georgiananaftanaila/Series-Voltage-Regulator/Layout/Layout.jpg

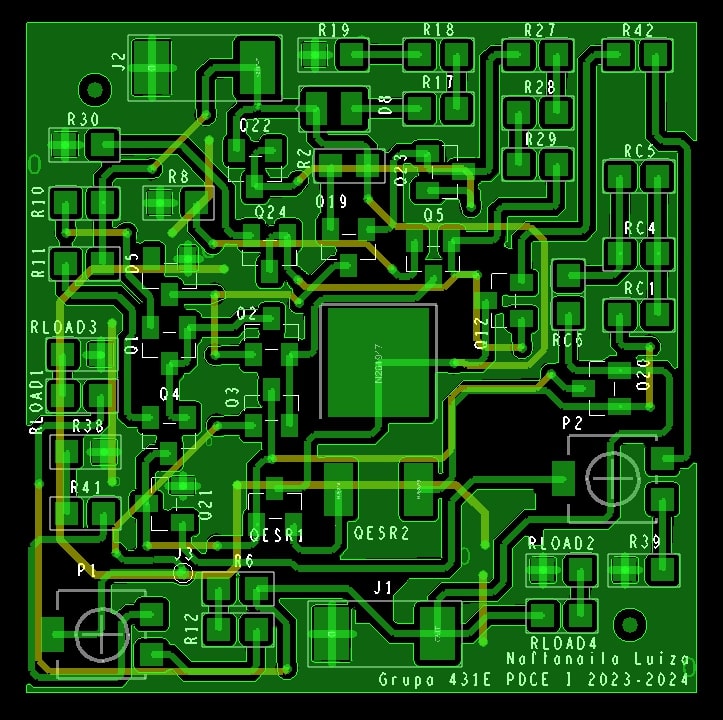
Layout/Layout.jpg
