georgiananaftanaila/Series-Voltage-Regulator/Proiect docs/Proiect1_Naftanaila_Luiza-Georgiana.pdf

Universitatea Națională de Știință si Tehnologie POLITEHNICA București

### FACULTATEA DE ELECTRONICĂ, TELECOMUNICAȚII ȘI TEHNOLOGIA INFORMAȚIEI

## STABILIZATOR DE TENSIUNE CU ELEMENT DE REGLAJ SERIE

## Proiect 1-DCE

Student: Năftănăilă Luiza-Georgiana

Grupa: 431E

Disciplină: PDCE

## Tema 7

(N = 17)

### 1. Date de proiectare

- Să se proiecteze și realizeze un stabilizator de tensiune cu ERS având următoarele caracteristici:

¨ Tensiunea de ieșire reglabilă în intervalul: 8.5-17 [V]

¨ Element de reglaj serie;

¨ Sarcina la ieșire 850 [Ω];

¨ Deriva termică < 2mV/°C;

¨ Protecție la suprasarcină prin limitarea temperaturii tranzistorului element de reglaj serie la 100 °C, si a curentului maxim la 0,4A;

¨ Tensiune de intrare în intervalul: 30.6-34 [V]

¨ Domeniul temperaturilor de funcționare: 0°C -70°C (verificabil prin testare în temperatură);

¨ Amplificarea în tensiune minimă (în buclă deschisă) a amplificatorului de eroare: minim 200;

¨ Semnalizarea prezenței tensiunilor de intrare/ieșire cu diodă de tip LED

## 2. Schema bloc- Stabilizator de tensiune ERS

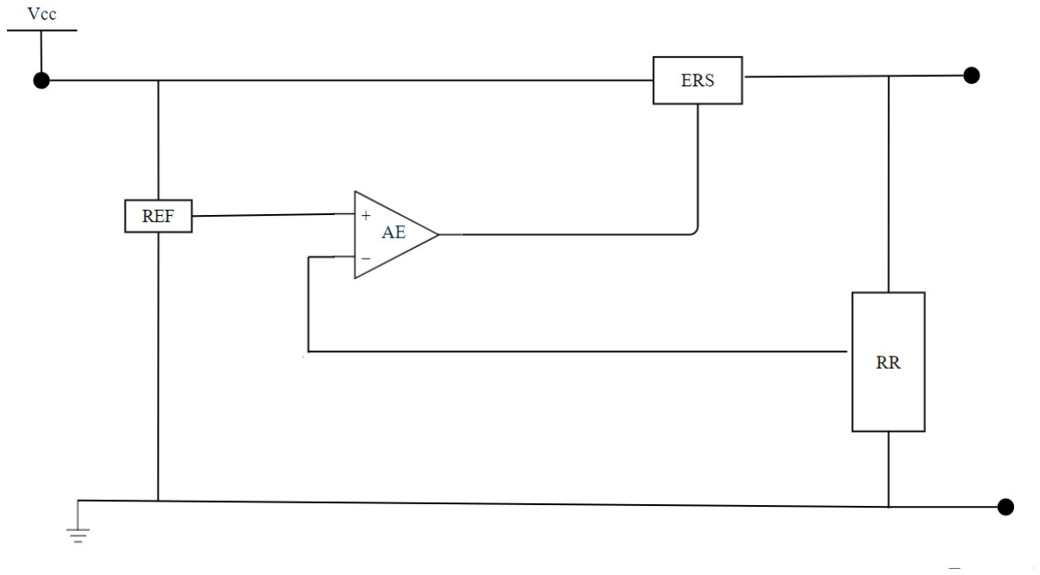
[picture p2: figure]

- REF – Referința de tensiune - asigură stabilitate în timp la variația tensiunii de intrare și a temperaturii;

- ERS - Elementul de reglaj serie - menține tensiunea de ieșire la nivelul specificat sub controlul amplificatorului de eroare;
- RR – Rețeaua de reacție negativă – preia semnalul de ieșire de la ieșirea amplificatorului în sensul scăderii amplitudinii acestuia;
- AE – Amplificatorul de eroare compară tensiunea de ieșire, pentru a acționa asupra elementului de reglaj;

## 3. Schema electrică

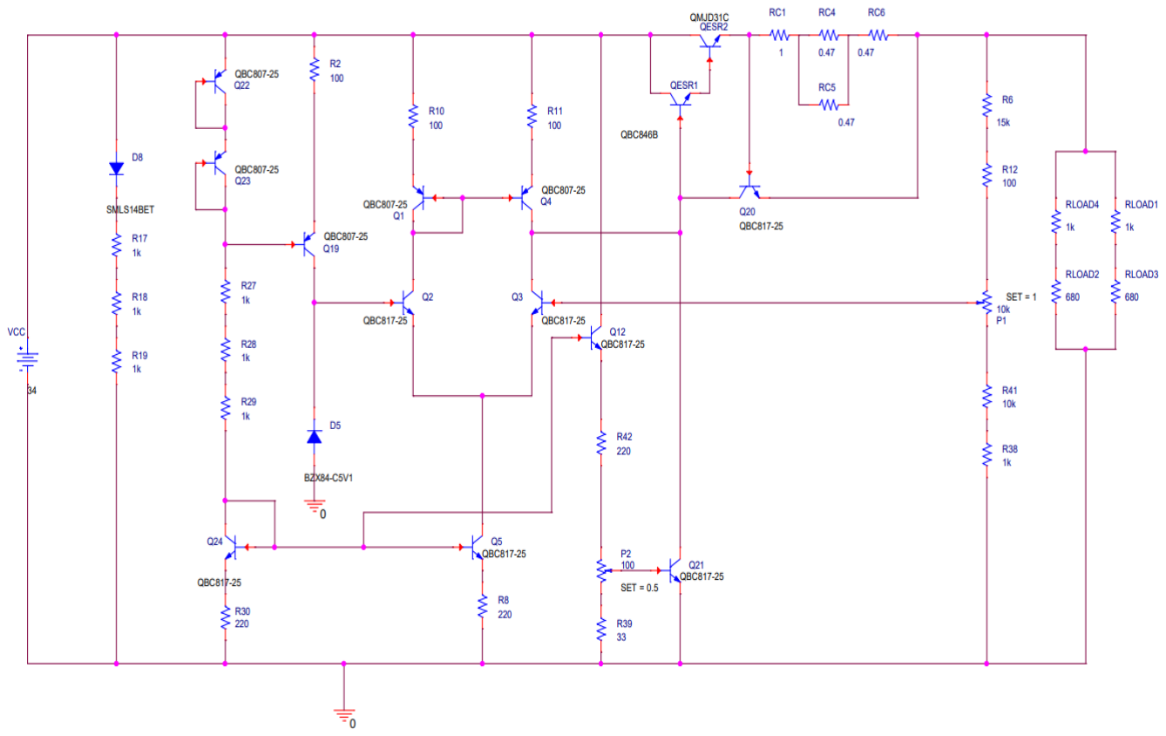
[picture p3: figure]

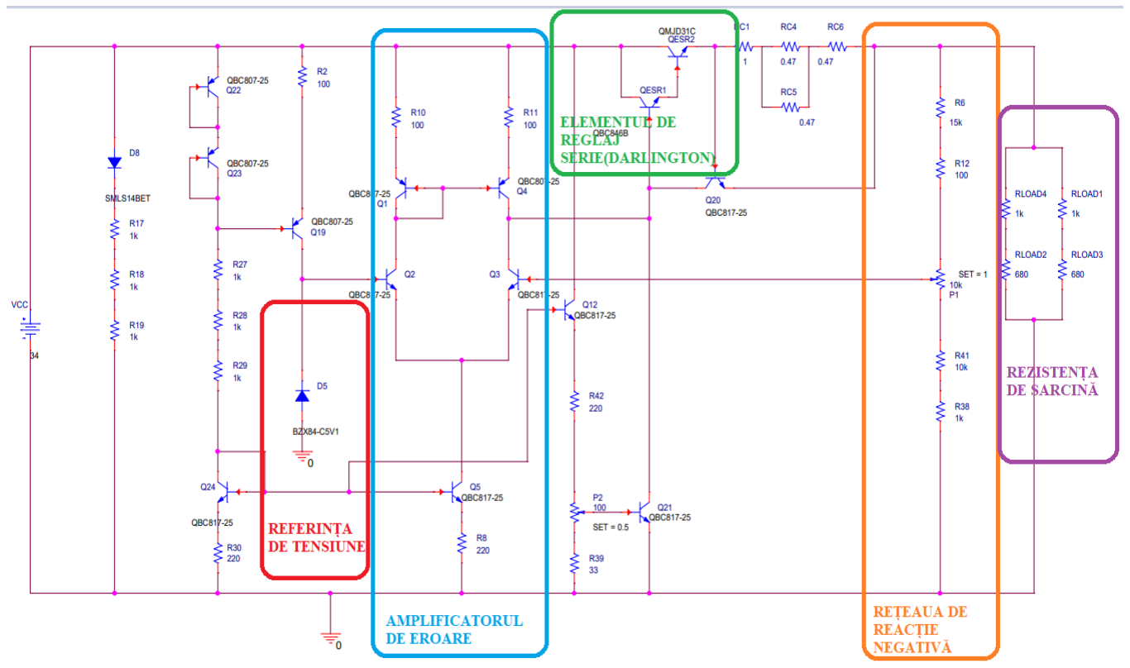
[picture p4: figure]

Rolul principalelor elemente din circuit:

- Dioda Zener, D5 este referința de tensiune și este polarizată de sursa de curent Q22,Q23,R2;
- Etajul diferențial Q2 și Q3, împreună cu sursa de curent Q5 și R8 și oglinda de curent Q1, Q4, R10 și R11 formează amplificatorul de eroare;
- Grupul QERS-QERS2 constituie elementul de reglaj serie, deoarece QESR2 este un tranzistor de putere (bF redus) care dă curentul prin sarcină. Tranzistorul QERS are rolul de demultiplicare a curentului de bază al lui QESR2 și face posibilă funcționarea amplificatorului de eroare la curenți acceptabili;
- Gruparea serie a rezistoarelor R6, R12, R37, R41, R38, R9, R34, împreună cu potențiometrul P1 formează rețeaua de reacție negativă, iar valorile acestora au fost alese astfel încât să regleze tensiunea de ieșire în intervalul dorit;
- Gruparea rezistoarelor RLOAD, RLOAD1-RLOAD7 formează rezistența de sarcină și au fost alese astfel încât puterea disipată pe fiecare dintre acestea să nu depășească 125 mW, impusă de producător;
- Oglinda de curent are rolul de a asigura curenți egali prin cele două ramuri;
- Q21 îndeplinește rolul senzorului de temperatură, iar tensiunea VBE a acestuia, la care poate să conducă un curent semnificativ, scade cu 2 mV/°C;
- Potențiometrul P2 are rolul de a ajusta valoarea divizorului de tensiune, R32, R42, R43, R39, P2, astfel încât tensiunea din emitorul lui Q12 să deschidă pe Q21 la circa 100°C;
- Valoarea diodei Zener a fost aleasă astfel încât coeficientul de variație cu temperatura să fie mic, aproape de 0, această dioda de 5.1V avand un drift termic foarte mic;
- Calculul PSF-ului de mai jos s-a realizat pentru o rezistență de sarcină de 850 Ω, dar aceasta a fost înlocuită cu un grup de mai multe rezistoare deoarece puterea disipată printr-o singură rezistență de această valoare este prea mare;
- Pentru a asigura un curent adecvat aprinderii LED-ului D8 s-au ales rezistoare de valoarea 1kΩ, respectiv 220Ω și 150Ω pentru aprinderea LED-ului D9;

- Rezistoarele ce fac parte din oglinda de curent au rolul de a egala cei doi curenți, având o cădere de tensiune mică pe aceștia;
- Rezistoarele înseriate cu LED-urile au rolul de a prelua o mare parte a tensiunii de intrare/ieșire;
- Tranzistorul Q20 împreună cu gruparea de rezistoare formată din RC1,RC4, RC5, RC6 asigură protecția la scurtcircuit. Valorile rezistoarelor au fost alese astfel încât prin tranzistorul QESR2 să fie forțat un curent mare și pentru a se asigura un curent optim pentru a ține tensiunea de ieșire constantă;
- Pentru potențiometrul ajustat la SET=1, valoarea tensiunii de ieșire se va calcula astfel:

Vz = Vo

R41+R38+P1
R6+R12+P1+R41+R38
- Vo = Vz

R6+R12+P1+R41+R38
R41+R38+P1

## 4. Calcul analitic și relații de dimensionare

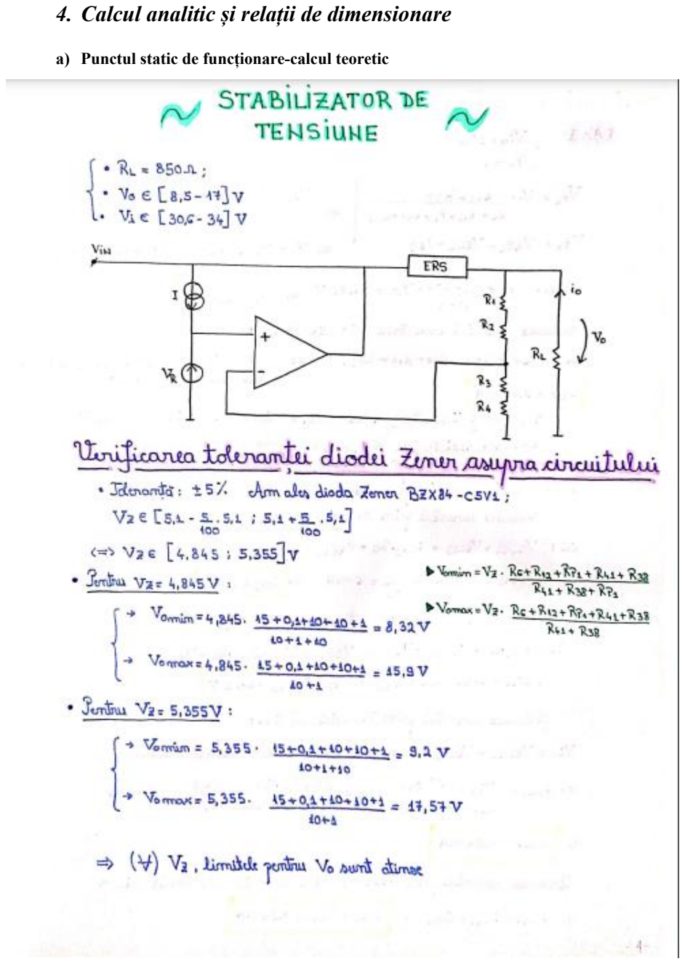
[picture p5: page 6]

a) Punctul static de funcționare-calcul teoretic

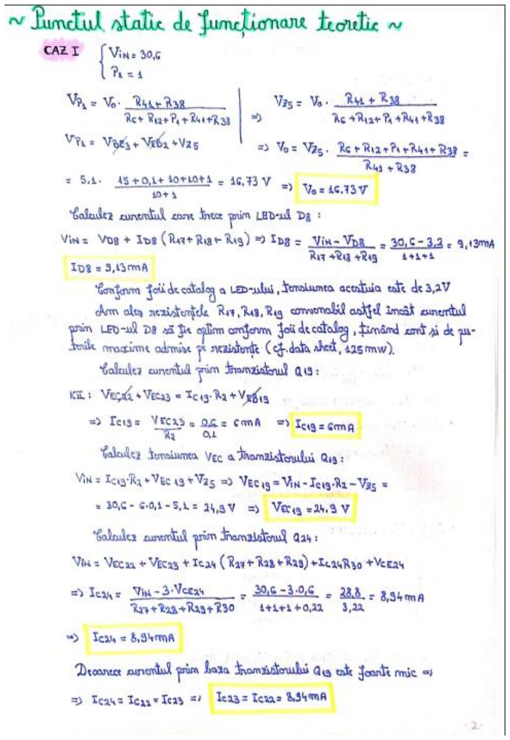
[picture p6: page 7]
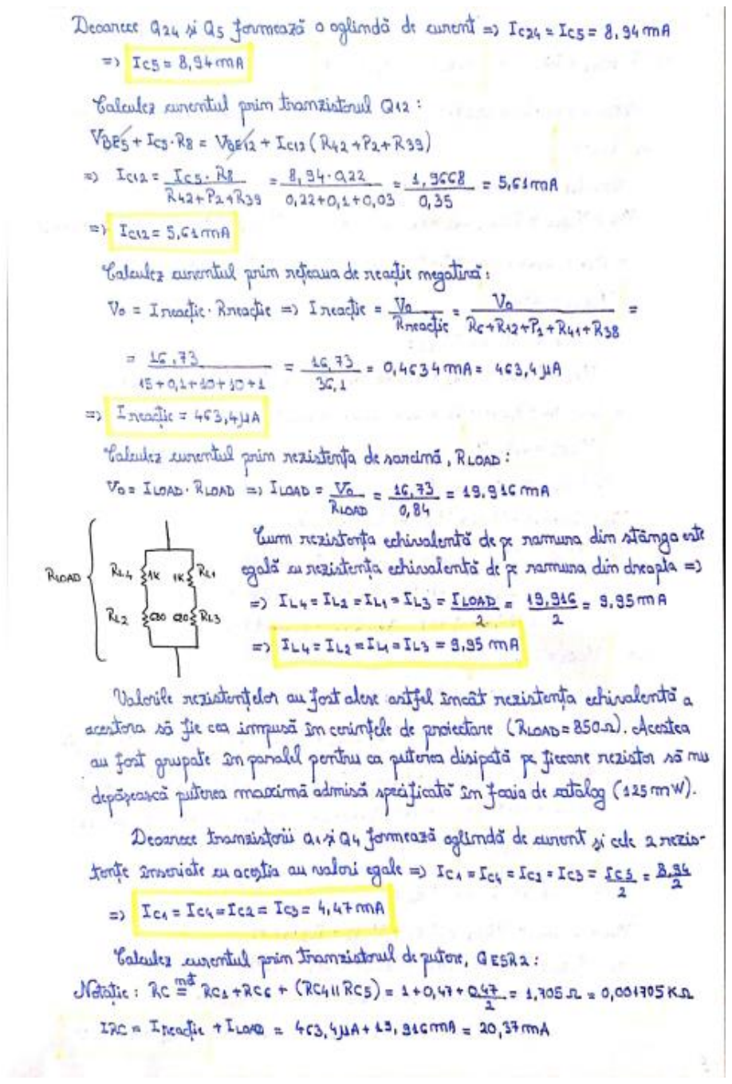
[picture p7: page 8]
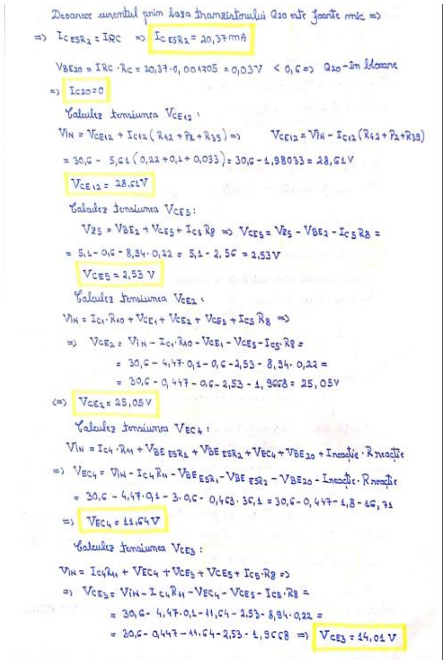
[picture p8: page 9]
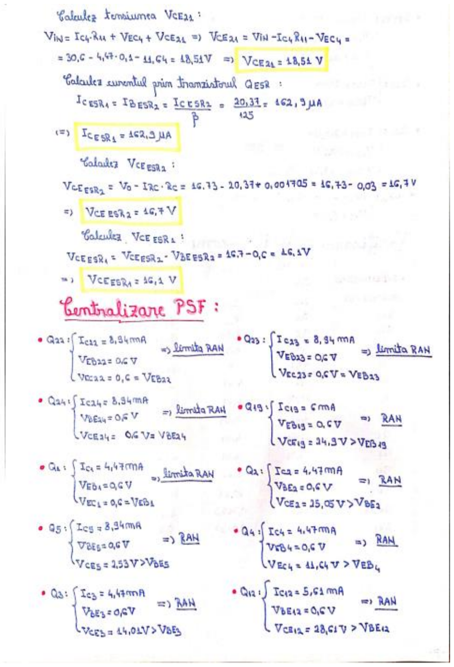
[picture p9: page 10]
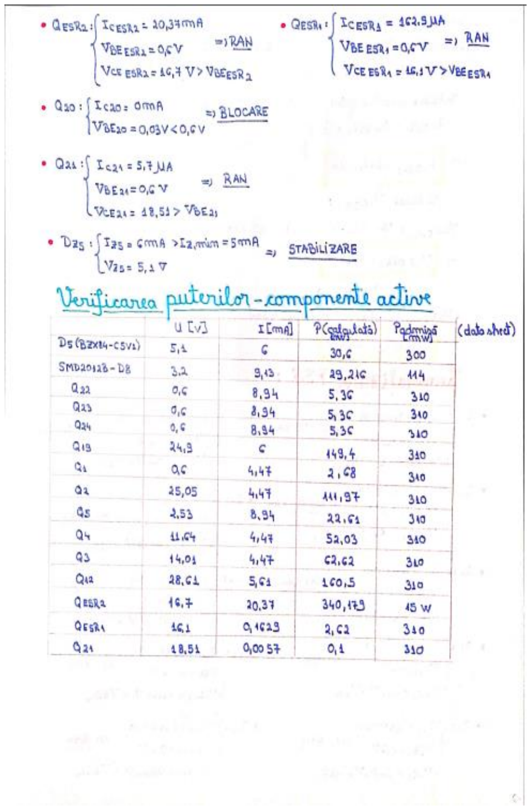
[picture p10: page 11]
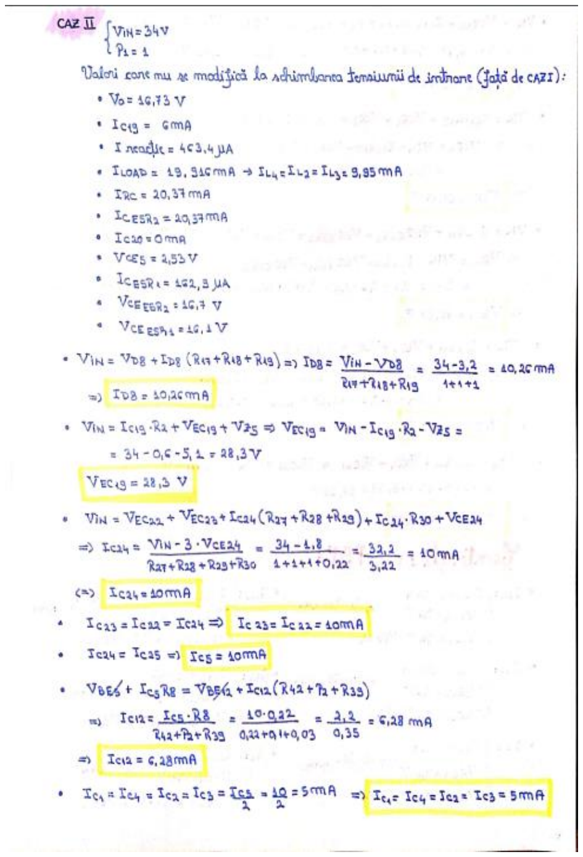
[picture p11: page 12]
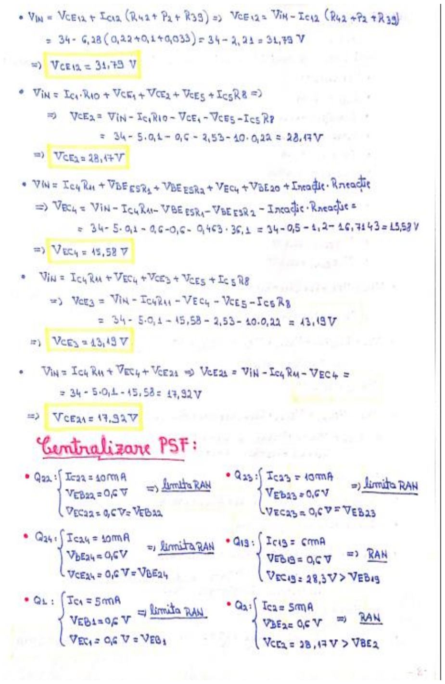
[picture p12: page 13]
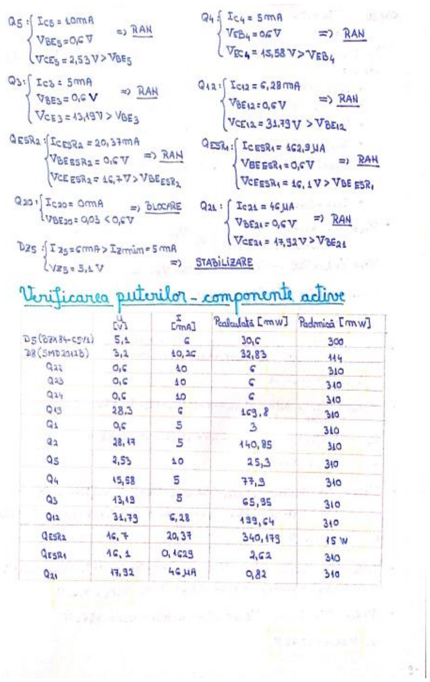
[picture p13: page 14]
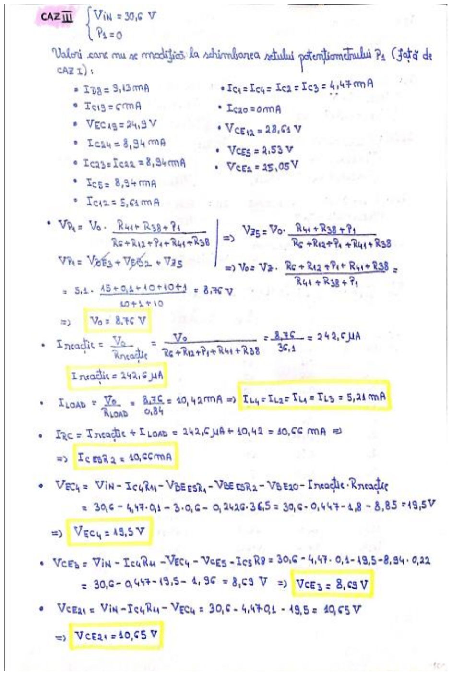
[picture p14: page 15]
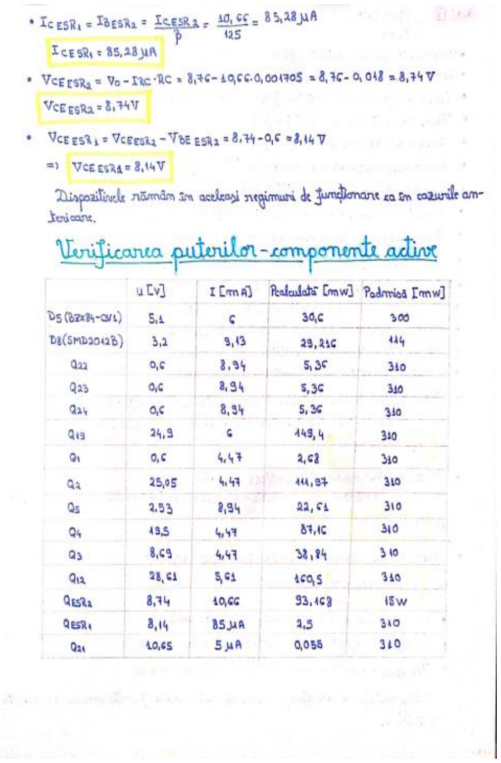
[picture p15: page 16]
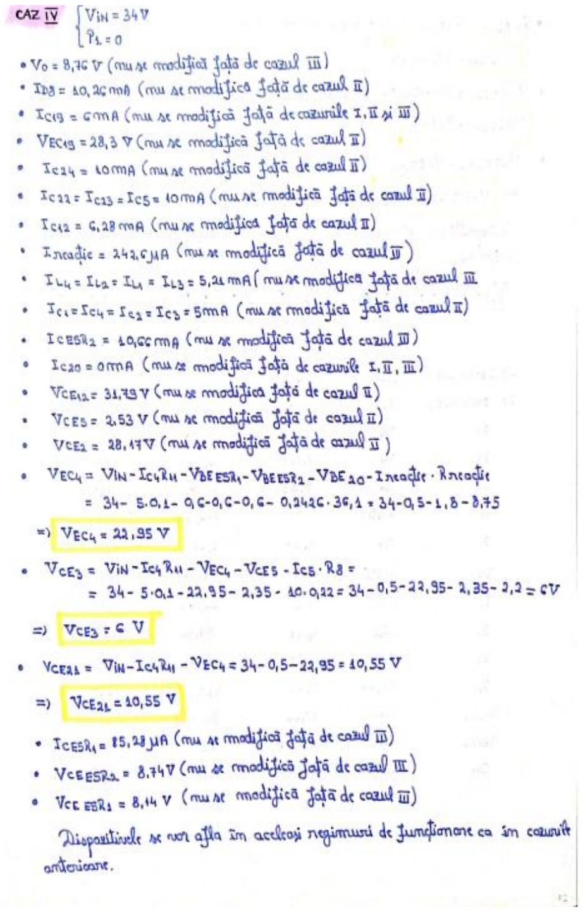
[picture p16: page 17]
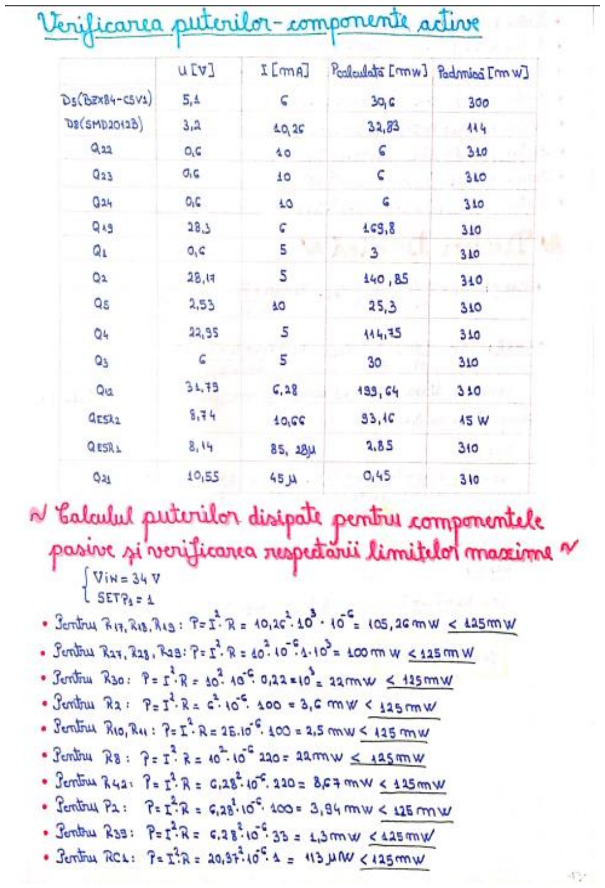
[picture p17: page 18]
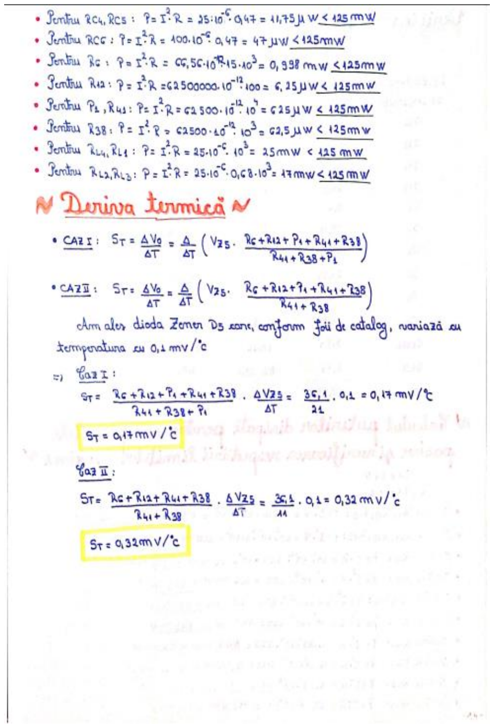
[picture p18: page 19]
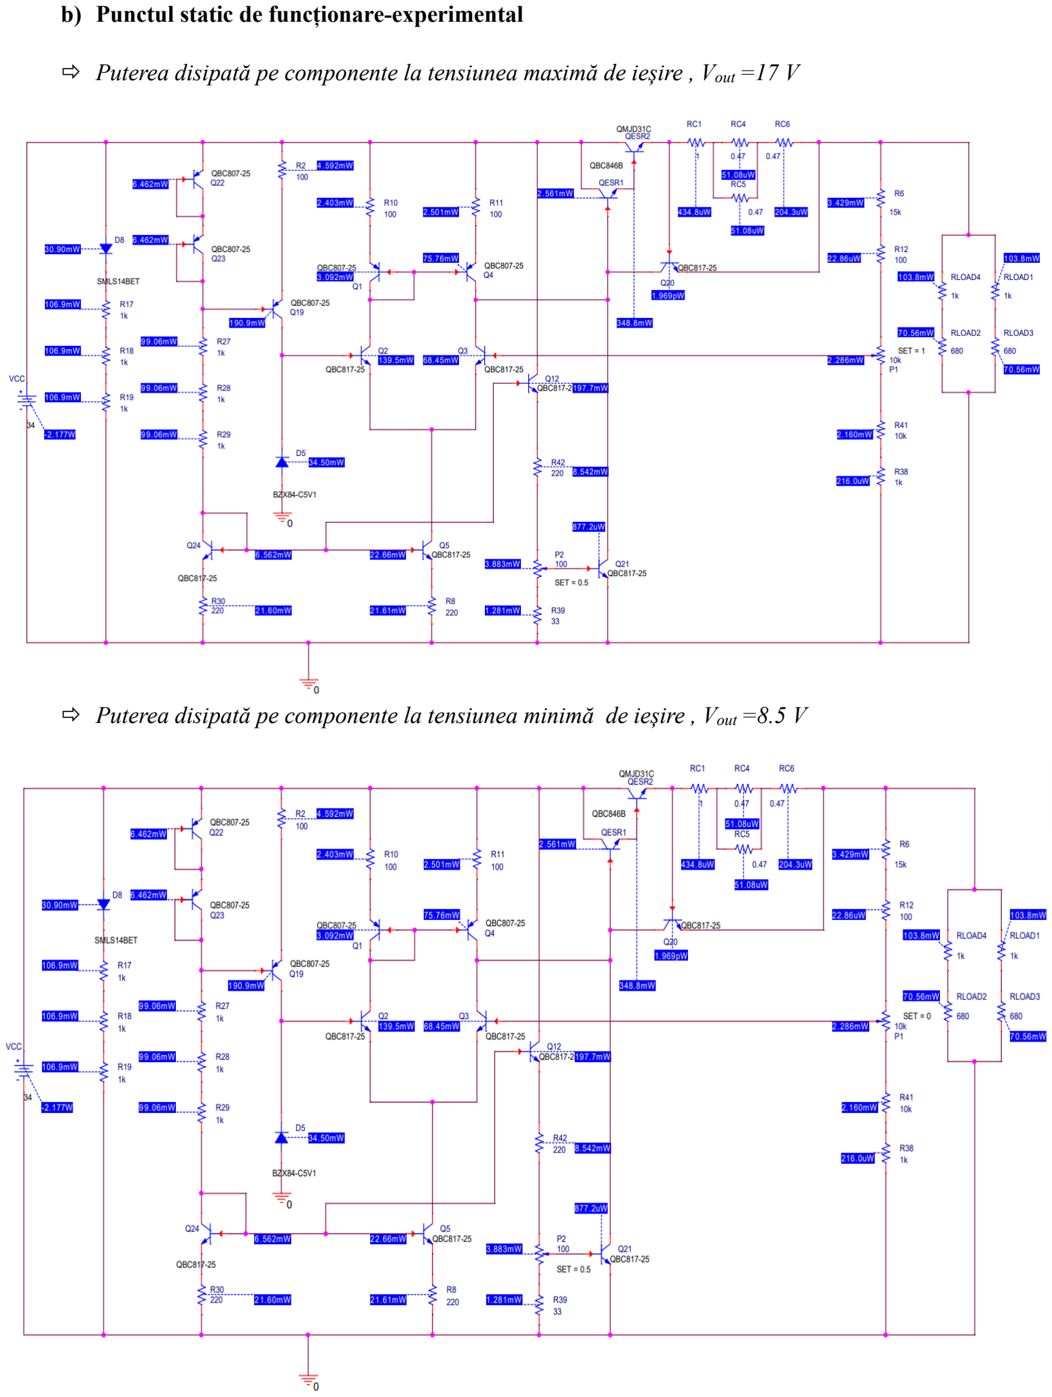
[picture p19: page 20]

b) Punctul static de funcționare-experimental
- Puterea disipată pe componente la tensiunea maximă de ieșire , Vout =17 V
- Puterea disipată pe componente la tensiunea minimă de ieșire , Vout =8.5 V

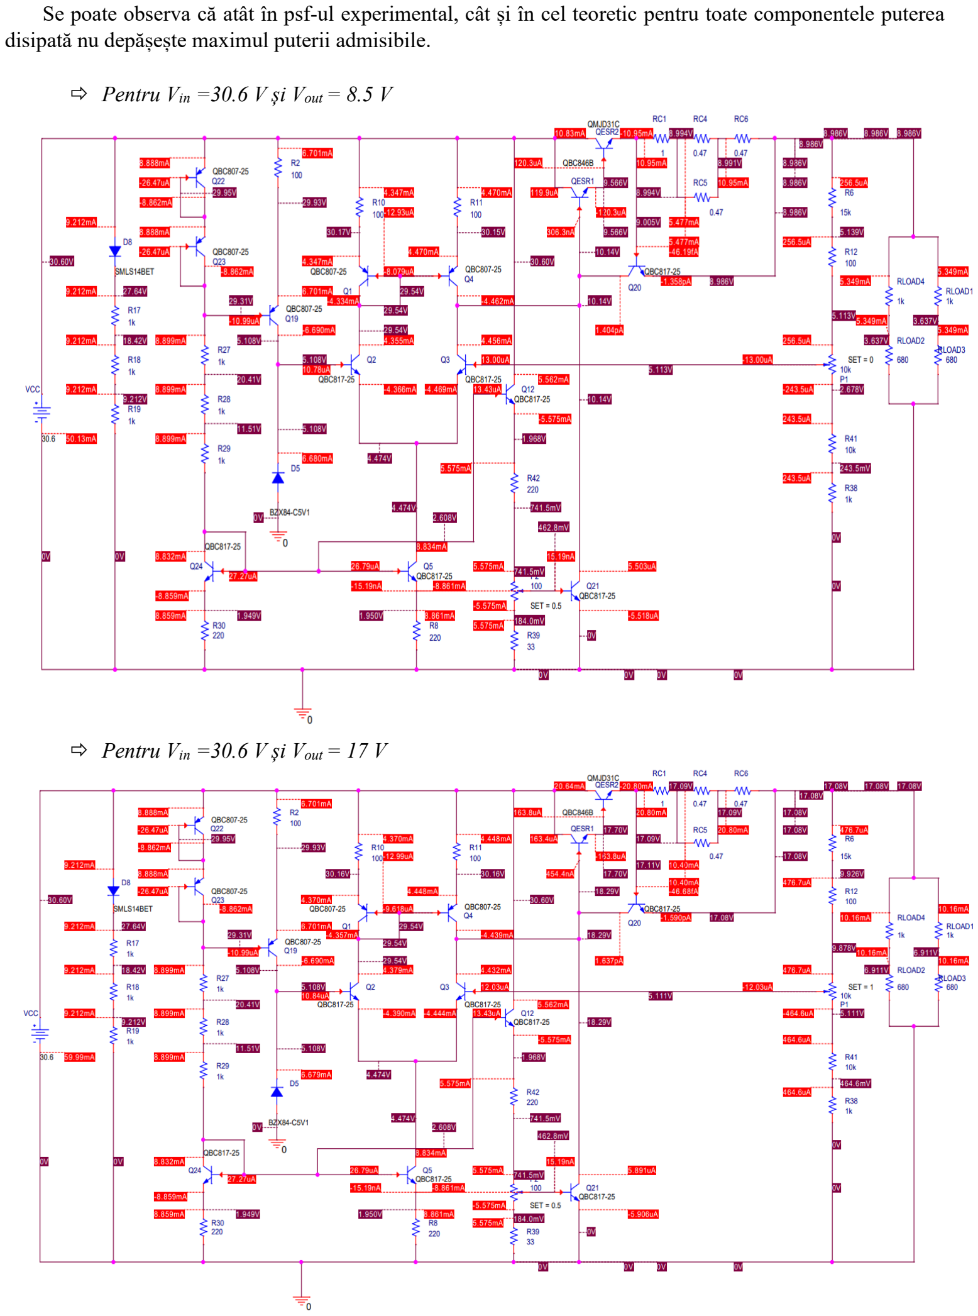
[picture p20: page 21]

Se poate observa că atât în psf-ul experimental, cât și în cel teoretic pentru toate componentele puterea disipată nu depășește maximul puterii admisibile.

- Pentru Vin =30.6 V și Vout = 8.5 V
- Pentru Vin =30.6 V și Vout = 17 V

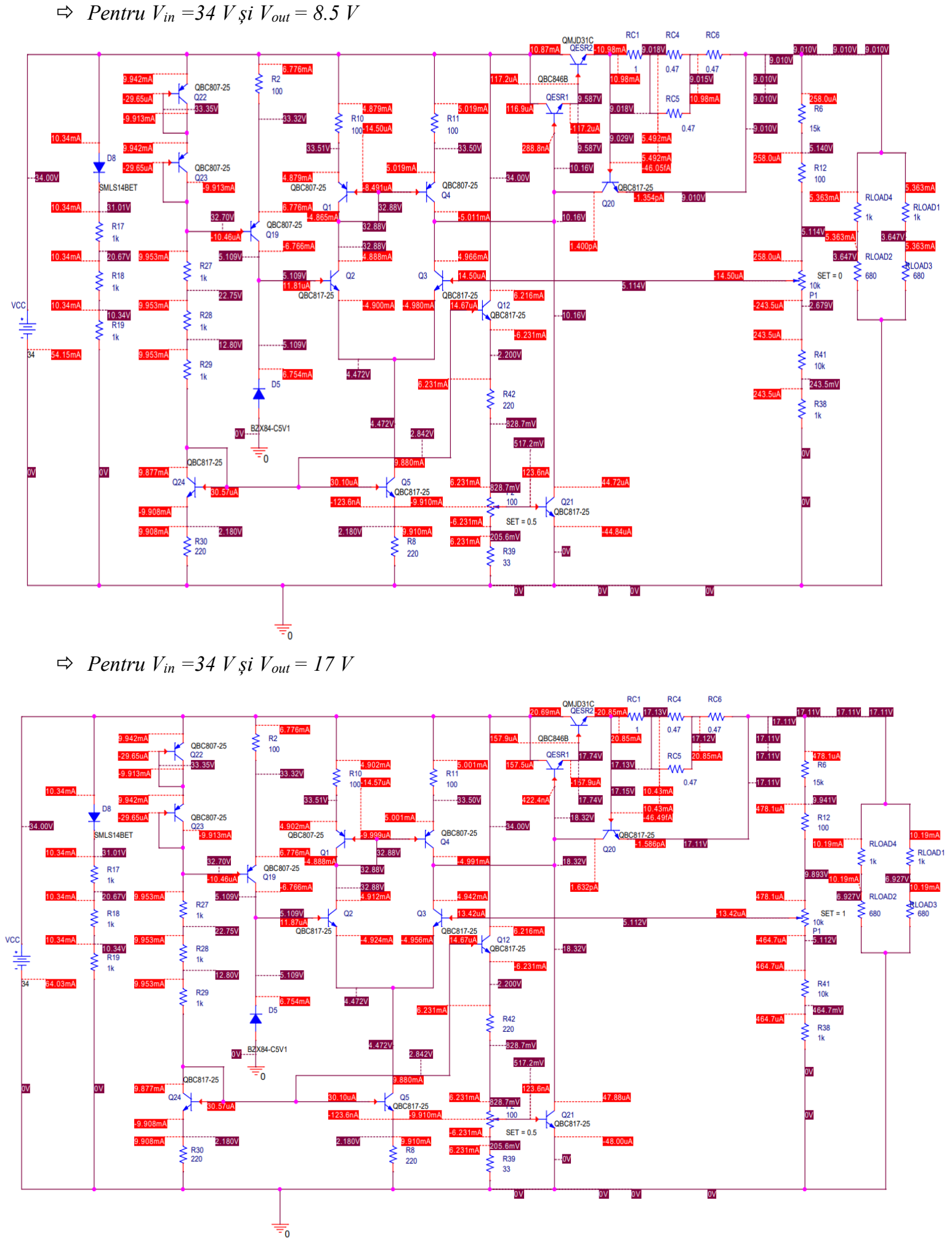
[picture p21: page 22]

- Pentru Vin =34 V și Vout = 8.5 V
- Pentru Vin =34 V și Vout = 17 V

## 5. Simulări

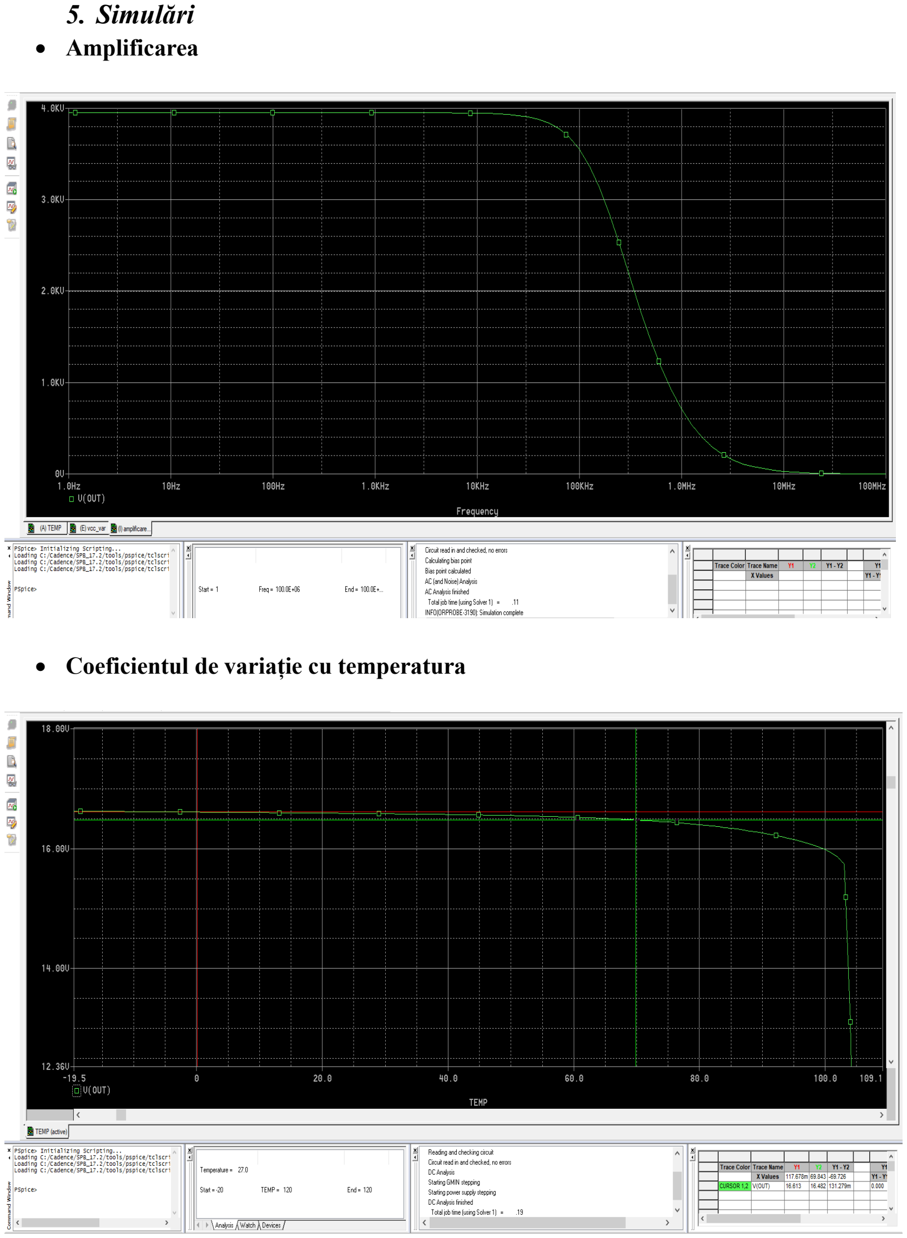
[picture p22: page 23]

- Amplificarea
- Coeficientul de variație cu temperatura

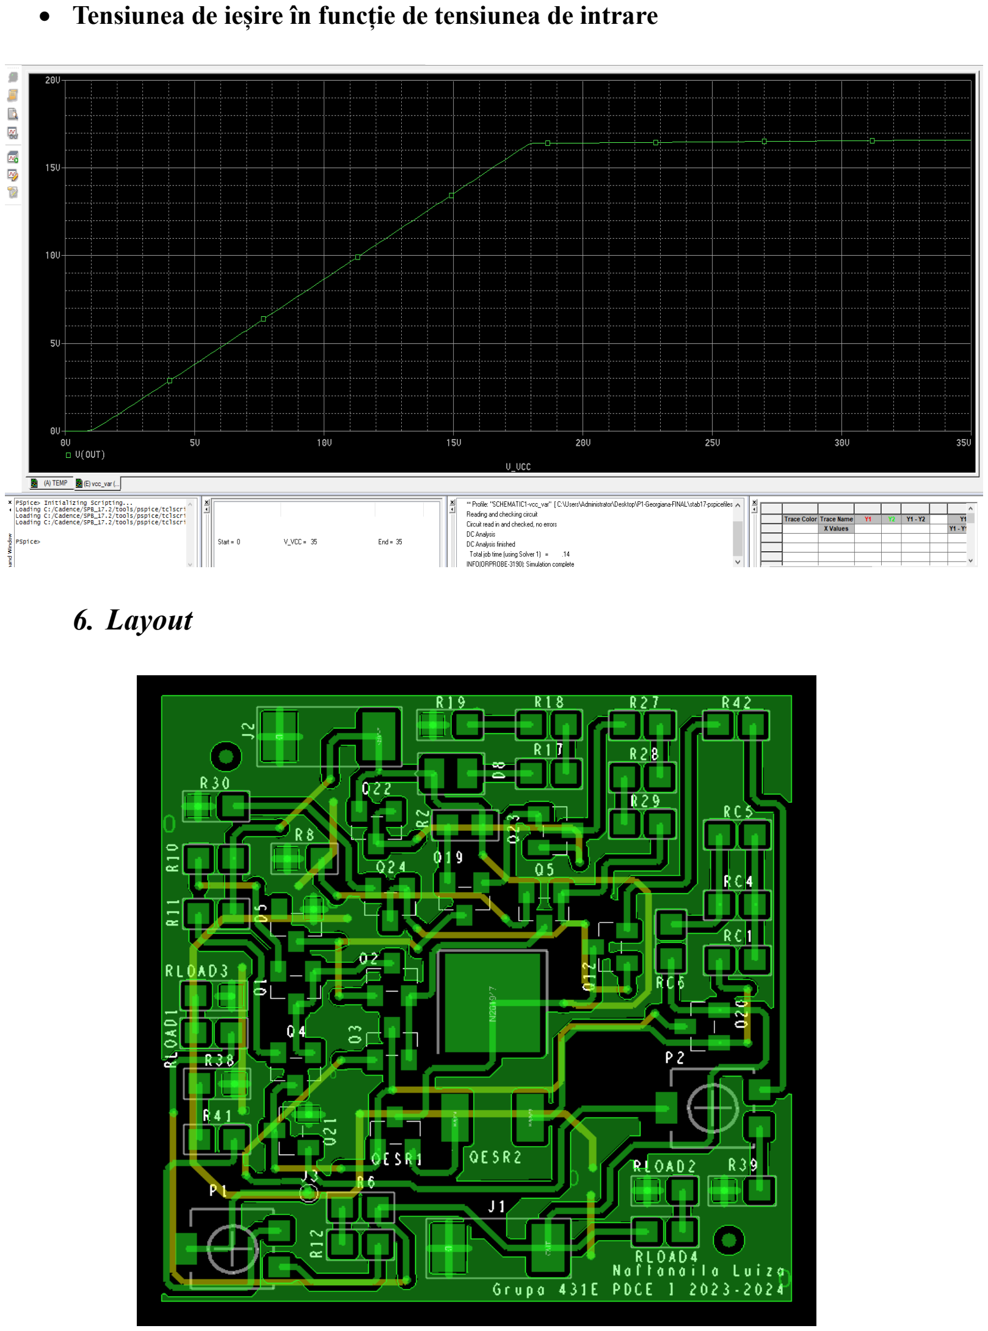
[picture p23: page 24]

- Tensiunea de ieșire în funcție de tensiunea de intrare

## 6. Layout

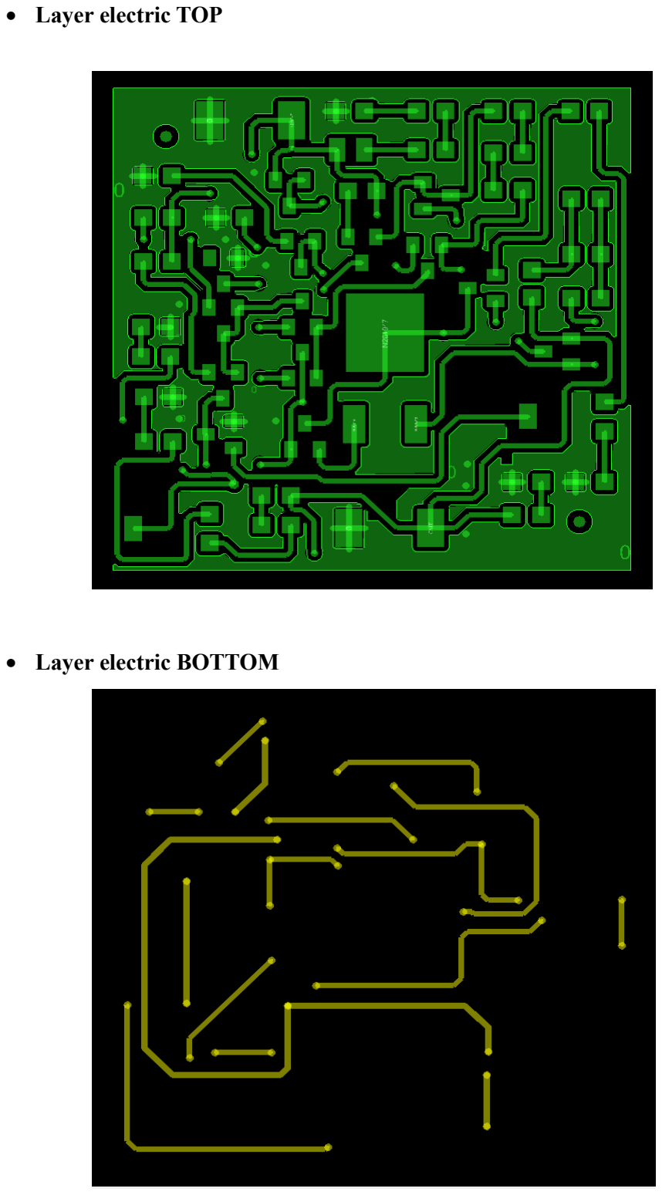
[picture p24: page 25]

- Layer electric TOP
- Layer electric BOTTOM

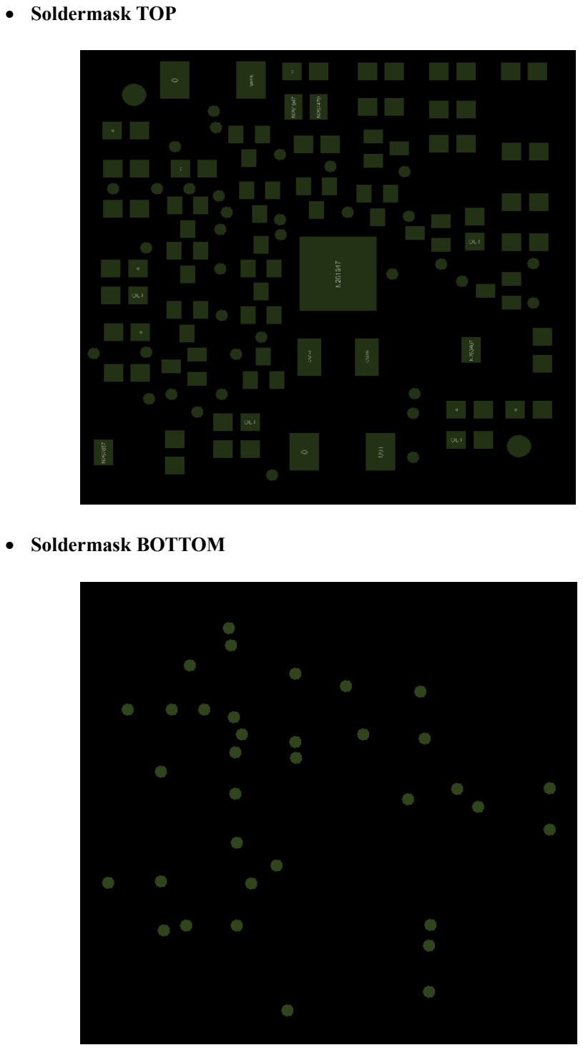
[picture p25: page 26]

- Soldermask TOP
- Soldermask BOTTOM

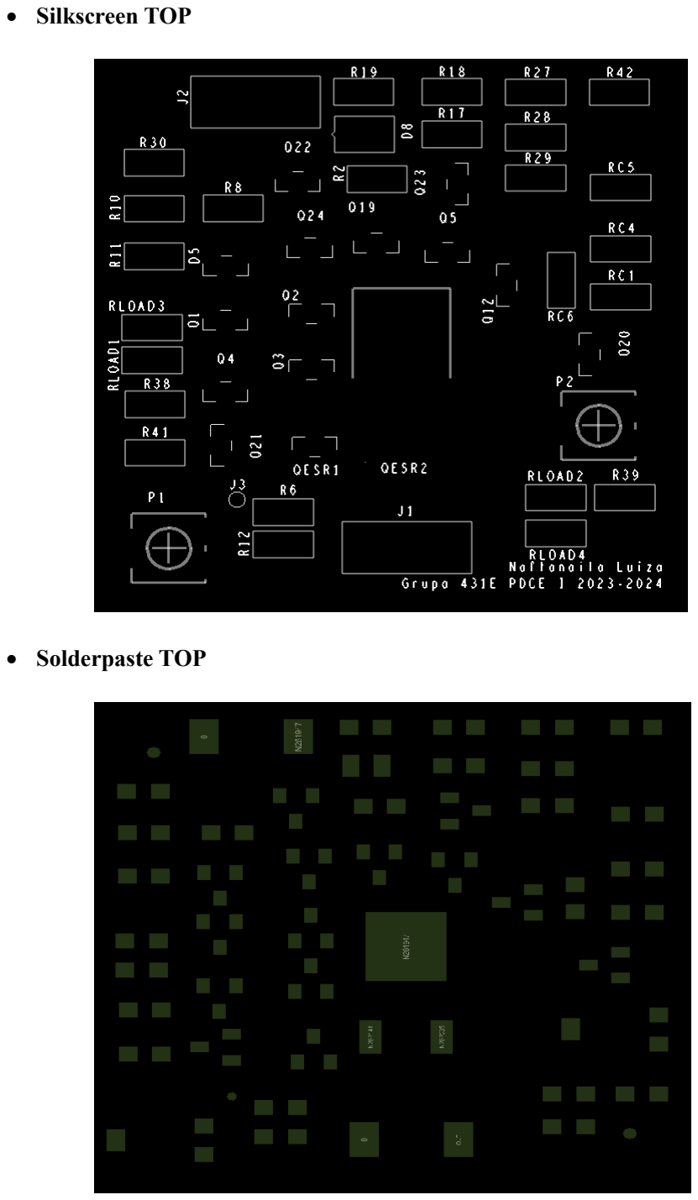
[picture p26: page 27]

- Silkscreen TOP
- Solderpaste TOP

- FAB

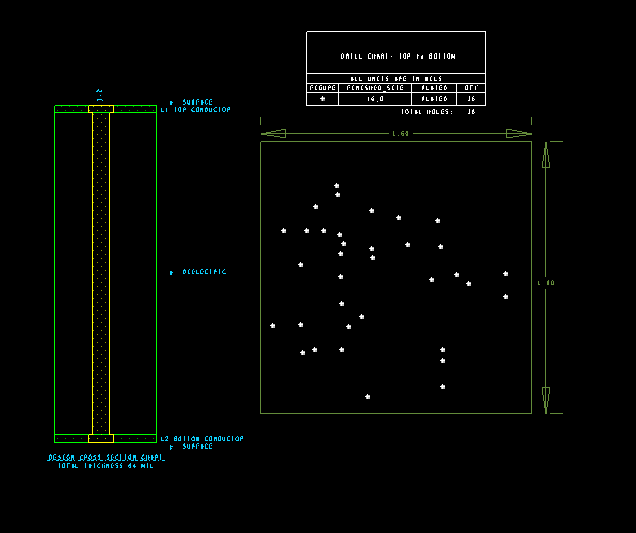
[picture p27: figure]

- Componentele active au fost poziționate cât mai aproape de mijlocul plăcuței deoarece acestea disipă putere, iar cele pasive au fost plasate pe marginea plăcii, în jurul componentelor active;
- Traseele de interconectare pentru semnal au fost alese de dimensiunea : 16 mil, traseele de interconectare pentru masă 0 (GND) au fost alese de dimensiunea de 20 mil deoarece prin acestea trec curenți de sute de mA. Traseele de interconectare pentru VCC au fost alese de dimensiunea 16 mil, deoarece, pentru orice tensiune din domeniul impus în cerințele de proiectare, curentul nu depășește 100 mA;
- Etajul diferențial împreună cu oglinda ce polarizează acest etaj au fost plasate astfel încât să fie realizată o împerechere termică bună.
- Conectorii au fost plasați la margini pentru a se realiza cu ușurință conexiunile din exterior.
