georgiananaftanaila/Series-Voltage-Regulator/Schematics/Schema electrică pentru layout.PNG

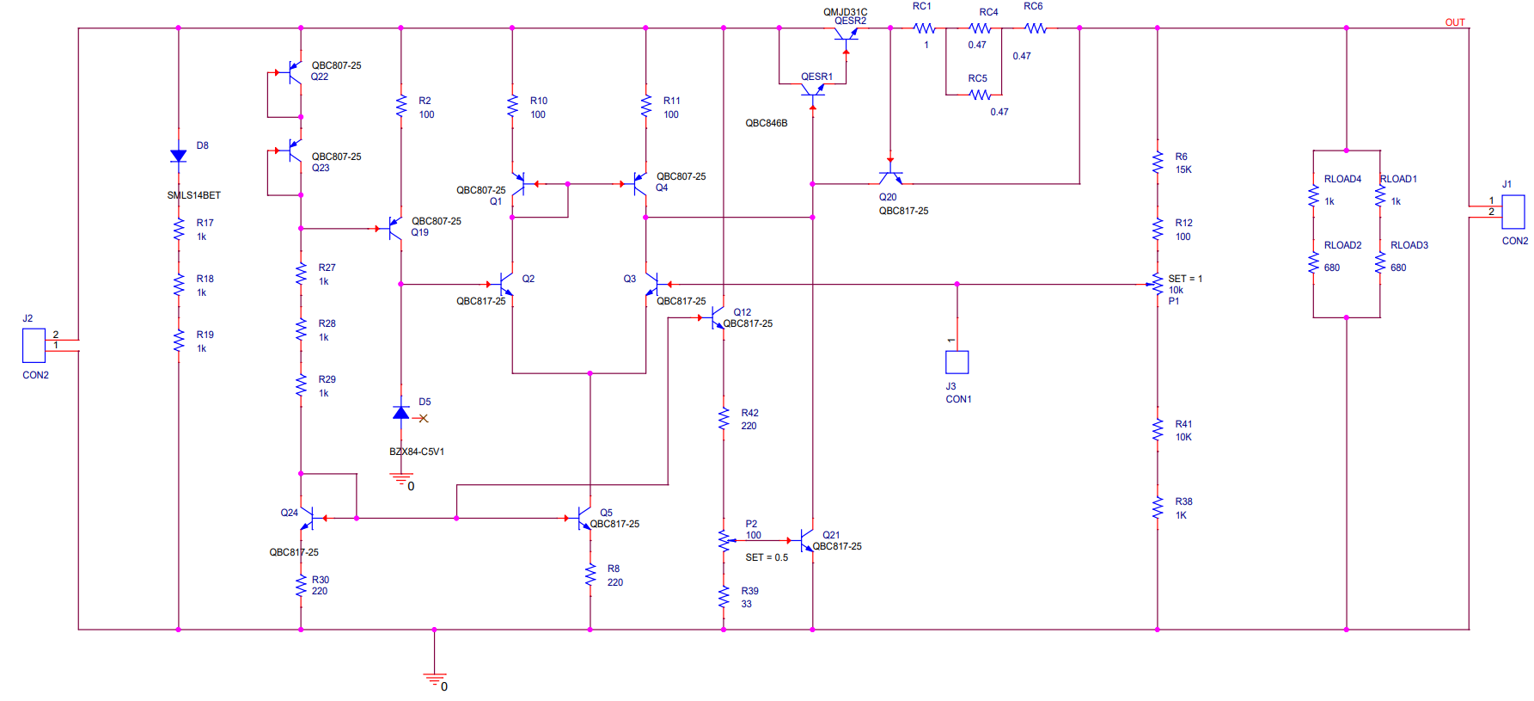
Schematics/Schema electrică pentru layout.PNG
