georgiananaftanaila/Series-Voltage-Regulator/Schematics/Schema electrică.jpg

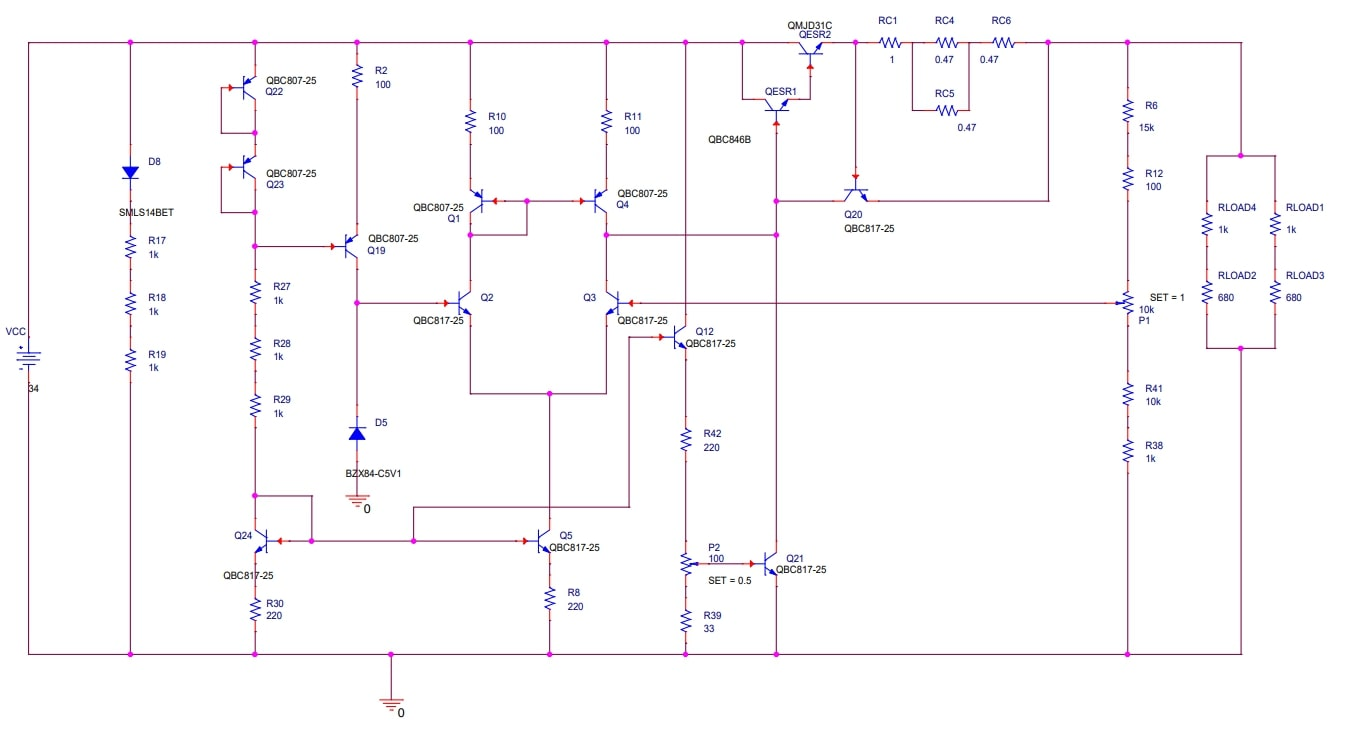
Schematics/Schema electrică.jpg
