georgiananaftanaila/Series-Voltage-Regulator/(list of files, drawings)

Other design files:
Schematics/Stabilizator de tensiune cu ERS/STABILIZATOR_DE_TENSIUNE_CU_ERS.DSN
Schematics/Stabilizator de tensiune cu ERS/Stabilizator_de_tensiune_cu_ERS.opj
